XrizZ/BRDF/Website/img/BlinnPhongFormula.png

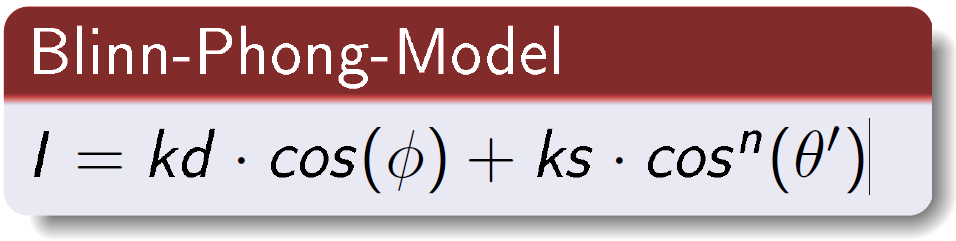
Website/img/BlinnPhongFormula.png
