XrizZ/BRDF/Website/img/IMG_0914.JPG

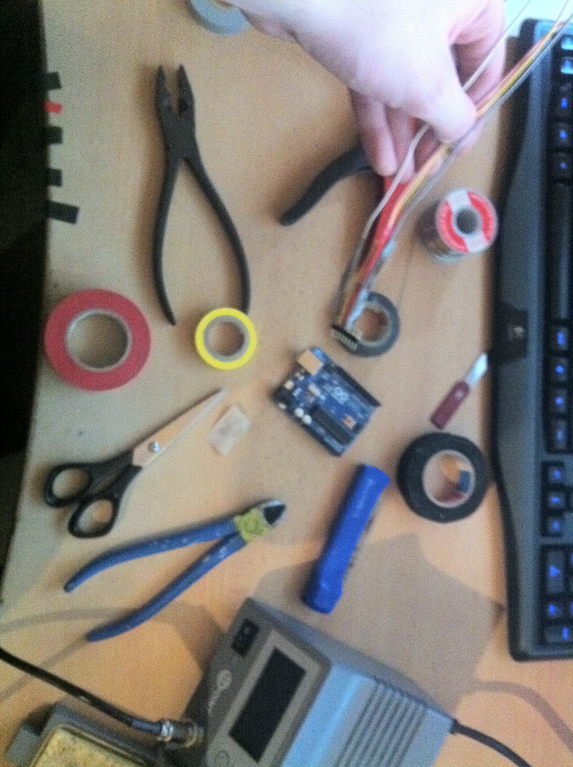
Website/img/IMG_0914.JPG
