XrizZ/BRDF/(list of files, cad)

Other CAD files:
levmar/Axb.obj
levmar/misc.obj
levmar/lm.obj
levmar/lmdemo.obj
levmar/lmblec.obj
levmar/lmbc.obj
levmar/lmbleic.obj
levmar/lmlec.obj
