XrizZ/BRDF/Arduino/led_ansteuerung.pde

/*
  Blink
  Turns on an LED on for one second, then off for one second, repeatedly.
 
  This example code is in the public domain.
 */

void setup()
{                
  // initialize the digital pin as an output.
  // Pin 13 has an LED connected on most Arduino boards:
  pinMode(0, OUTPUT);     
  pinMode(1, OUTPUT);
  pinMode(2, OUTPUT);
  pinMode(3, OUTPUT);
  pinMode(4, OUTPUT);
  pinMode(5, OUTPUT);
  pinMode(6, OUTPUT);
  pinMode(7, OUTPUT);
}

void loop()
{
  //Ascending();
  //Flashlight();
  Show();
  //KnightRiderx2();
  //KnightRiderx4();
  //TwoCircles();
  //Circle();
}

void Circle()
{
  int onTime = 50;
  int offTime = 1;
  
  OneOnOFF(1, onTime, offTime);
  OneOnOFF(2, onTime, offTime);
  OneOnOFF(3, onTime, offTime);
  OneOnOFF(4, onTime, offTime);
  OneOnOFF(8, onTime, offTime);
  OneOnOFF(12, onTime, offTime);
  OneOnOFF(16, onTime, offTime);
  OneOnOFF(15, onTime, offTime);
  OneOnOFF(14, onTime, offTime);
  OneOnOFF(13, onTime, offTime);
  OneOnOFF(9, onTime, offTime);
  OneOnOFF(5, onTime, offTime);  
}

void TwoCircles()
{
  int onTime = 50;
  int offTime = 1;

  TwoVirtuallyOn(1, 11, onTime);
  TwoVirtuallyOn(2, 7, onTime);
  TwoVirtuallyOn(3, 6, onTime);
  TwoVirtuallyOn(4, 10, onTime);
  TwoVirtuallyOn(8, 11, onTime);
  TwoVirtuallyOn(12, 7, onTime);  
  TwoVirtuallyOn(16, 6, onTime);
  TwoVirtuallyOn(15, 10, onTime);
  TwoVirtuallyOn(14, 11, onTime);
  TwoVirtuallyOn(13, 7, onTime);
  TwoVirtuallyOn(9, 6, onTime);
  TwoVirtuallyOn(5, 10, onTime);
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
  {
    //enable led 1
    digitalWrite(0, LOW);
    digitalWrite(1, LOW);
    digitalWrite(2, HIGH);
    digitalWrite(3, LOW);
    
    digitalWrite(4, HIGH);
    digitalWrite(5, HIGH);
    digitalWrite(6, HIGH);
    digitalWrite(7, LOW);
    
    delay(onTime);    
    return;
  }
  
  if(numLED == 16)
  {
    //enable led 1
    digitalWrite(0, LOW);
    digitalWrite(1, LOW);
    digitalWrite(2, LOW);
    digitalWrite(3, HIGH); 
    
    digitalWrite(4, HIGH);
    digitalWrite(5, HIGH);
    digitalWrite(6, HIGH);
    digitalWrite(7, LOW);
    
    delay(onTime);    
    return;
  }
}
