XrizZ/BRDF/stdafx.h

// stdafx.h : include file for standard system include files,
// or project specific include files that are used frequently, but
// are changed infrequently
//

#pragma once

#include "targetver.h"

#include <stdio.h>
#include <tchar.h>

const double PI = 3.1415926535897932384626433832795;
const double PIOVER180 = 0.01745329251994329576923690768489;
